PurplesparkA/arduino_enclosure_envctrl/other_files/cover_v2.stl

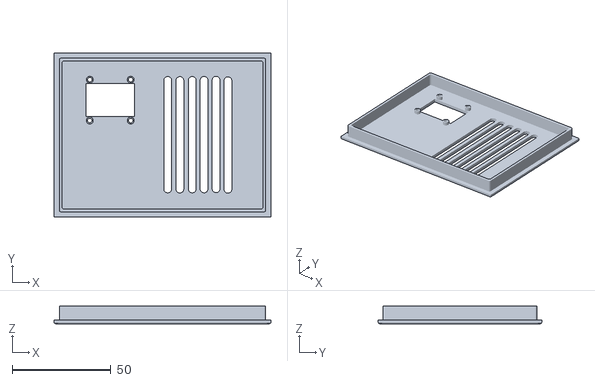
[picture p2: CAD file, 2021-04-09]
other_files/cover_v2.stl
110.0 x 83.0 x 9.00
