PurplesparkA/arduino_enclosure_envctrl/(list of files, cad)

Other CAD files:
other_files/Enclosure temperature control box v11.f3d
