PurplesparkA/arduino_enclosure_envctrl/test/README

This directory is intended for PlatformIO Unit Testing and project tests.

Testing
