PurplesparkA/arduino_enclosure_envctrl/(commit log)

2021-04-02 Add Arduino Nano to platformio.ini
2021-04-02 Add temp sensor
2021-04-02 Add display and temperature sensors
2021-04-03 Sensors and relays and fans added
2021-04-04 Add fan on icon
2021-04-08 Adding STL + diagram + Fusion360 source
    [Enclosure temperature control box v10.f3d, box.stl, cover.stl]
2021-04-08 set the relay status before initializing the relay pins
2021-04-08 change relay pins
2021-04-08 BoM in README
2021-04-09 New versions of STL and f3d
    [Enclosure temperature control box v10.f3d, Enclosure temperature control box v11.f3d, box.stl, box_v2.stl, cover.stl, cover_v2.stl]
